bgunebakan/Robotic-arm/zortrax robot arm/manual Robotic Arm/Ver 2015/SolidWorks files/Grasper Assembly.SLDASM

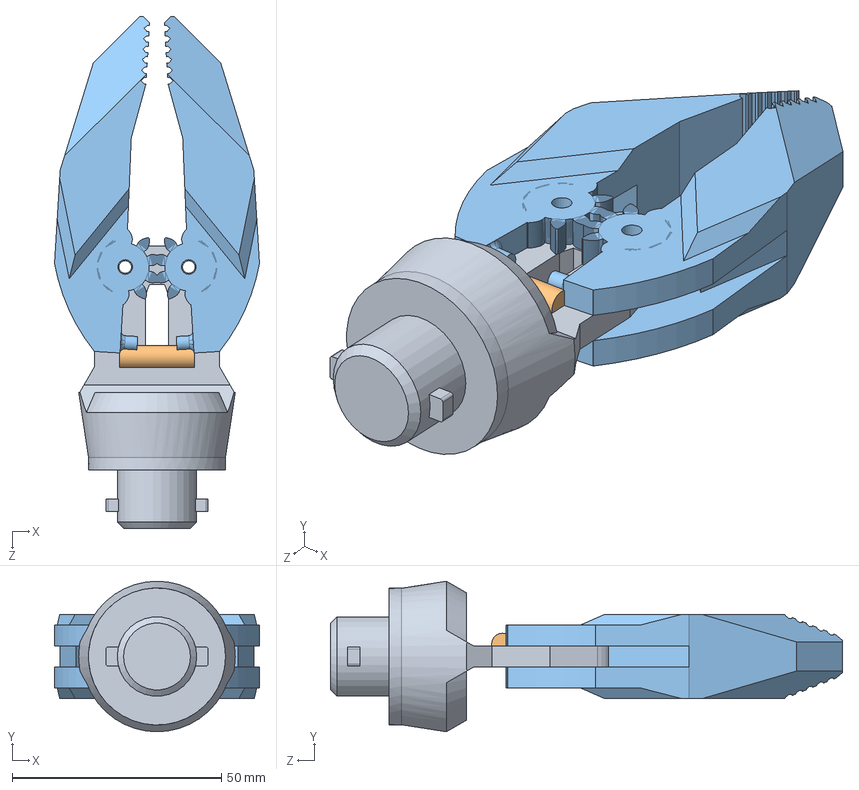
[picture p1: CAD file, 2015-10-21]
zortrax robot arm/manual Robotic Arm/Ver 2015/SolidWorks files/Grasper Assembly.SLDASM
49.0 x 36.0 x 122.4 mm
Grasper Body
Spring
Grasper x 2
