bgunebakan/Robotic-arm/bilalin yolu/Robot Arm New.SLDASM

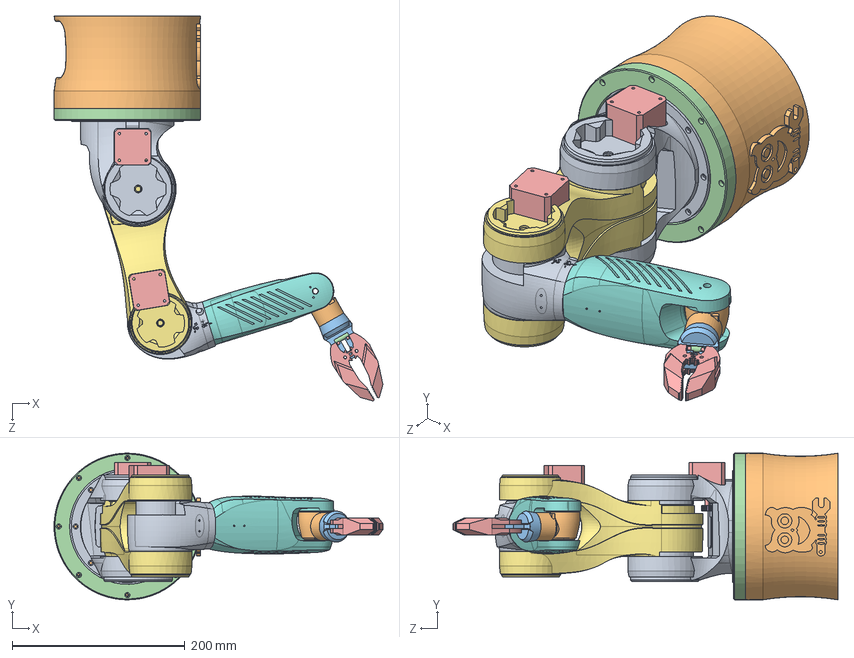
[picture p2: CAD file, 2015-11-02]
bilalin yolu/Robot Arm New.SLDASM
381.2 x 170.0 x 446.2 mm
Base
Support
Ball x 32
Ring
Small Gear x 3
arm
Nema 17 x 33 x 3
arm3
arm2
arm5
Grasper Body
Spring
Grasper x 2
Bearing 608 x 4
Shaft 8x80 x 2
