bgunebakan/Robotic-arm/zortrax robot arm/manual Robotic Arm/Ver 2015/SolidWorks files/Robot Arm New.SLDASM

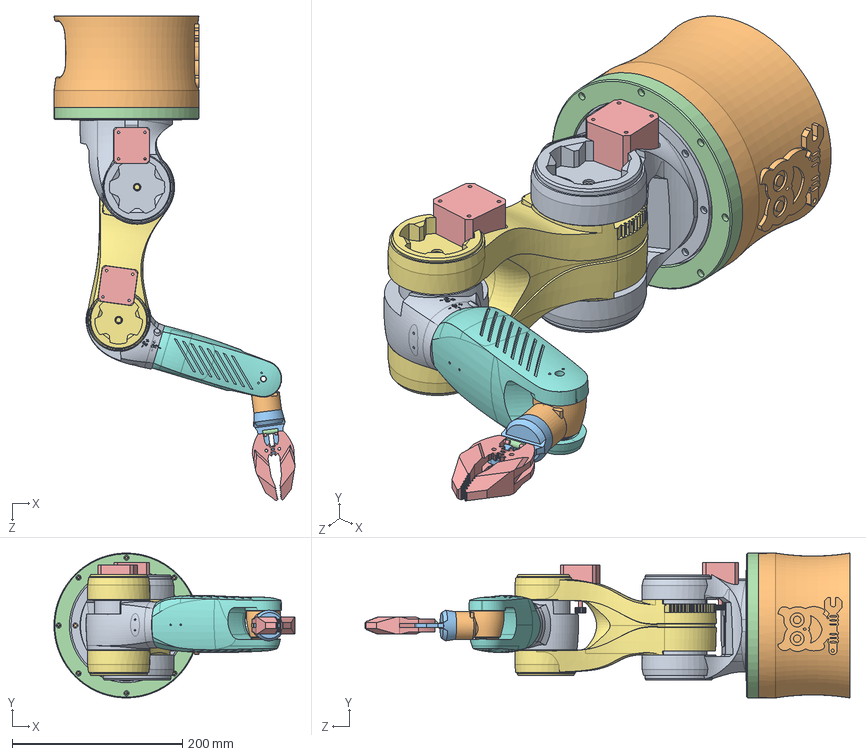
[picture p3: CAD file, 2015-10-21]
zortrax robot arm/manual Robotic Arm/Ver 2015/SolidWorks files/Robot Arm New.SLDASM
282.8 x 170.0 x 568.5 mm
Base
Support
Ball x 32
Ring
Small Gear x 3
arm
Nema 17 x 33 x 3
arm3
arm2
arm5
Grasper Body
Spring
Grasper x 2
Bearing 608 x 4
Shaft 8x80 x 2
