bgunebakan/Robotic-arm/bilalin yolu/Ring.sldprt

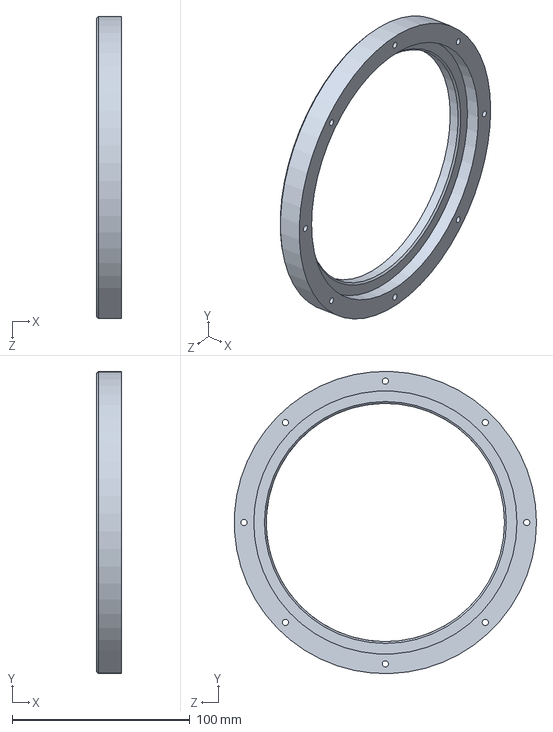
[picture p4: CAD file, 2015-11-02]
bilalin yolu/Ring.sldprt
14.0 x 169.9 x 169.9 mm
