bgunebakan/Robotic-arm/bilalin yolu/STL/Base.STL

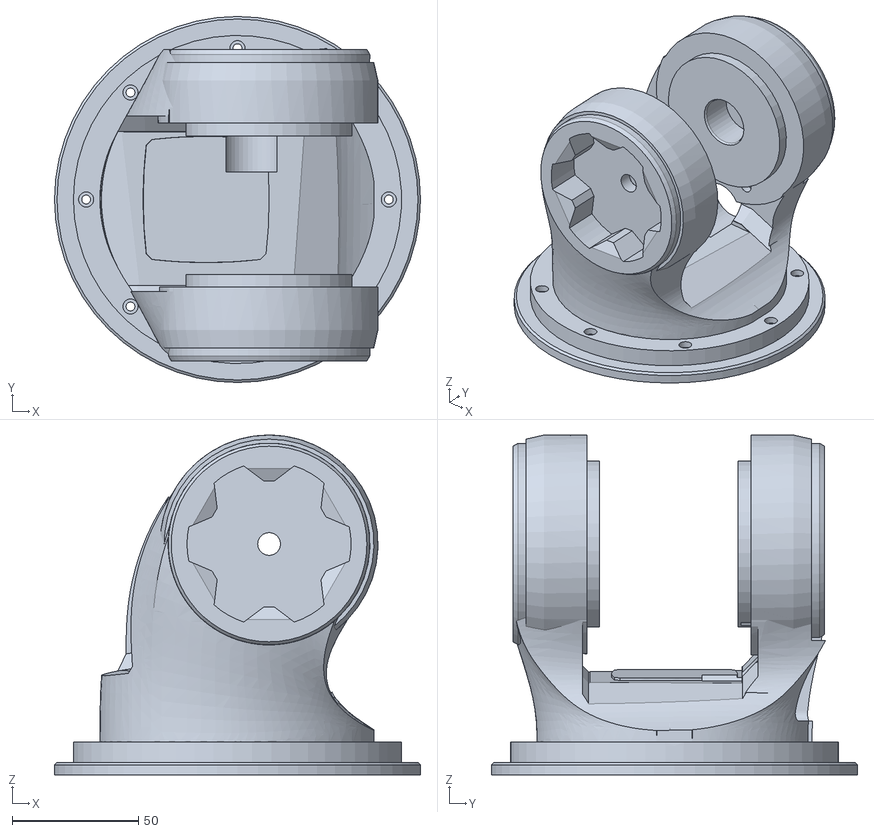
[picture p5: CAD file, 2015-11-02]
bilalin yolu/STL/Base.STL
145.0 x 145.0 x 134.7
