bgunebakan/Robotic-arm/zortrax robot arm/manual Robotic Arm/Ver 2015/Small gear.stl

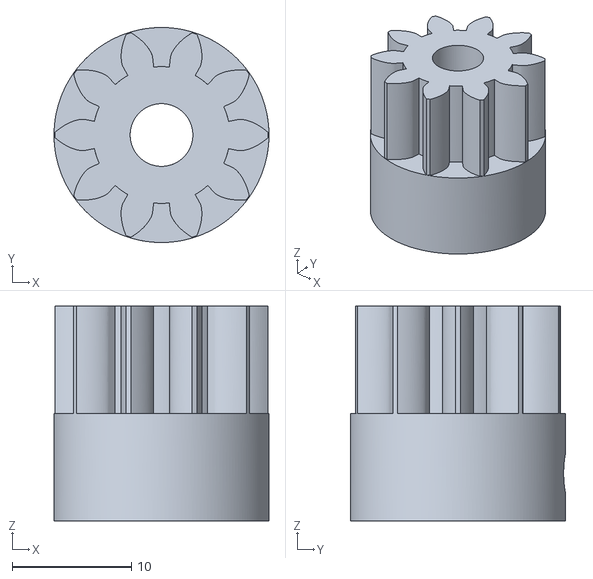
[picture p6: CAD file, 2015-10-19]
zortrax robot arm/manual Robotic Arm/Ver 2015/Small gear.stl
18.0 x 18.0 x 18.0
