bgunebakan/Robotic-arm/bilalin yolu/STL/arm.STL

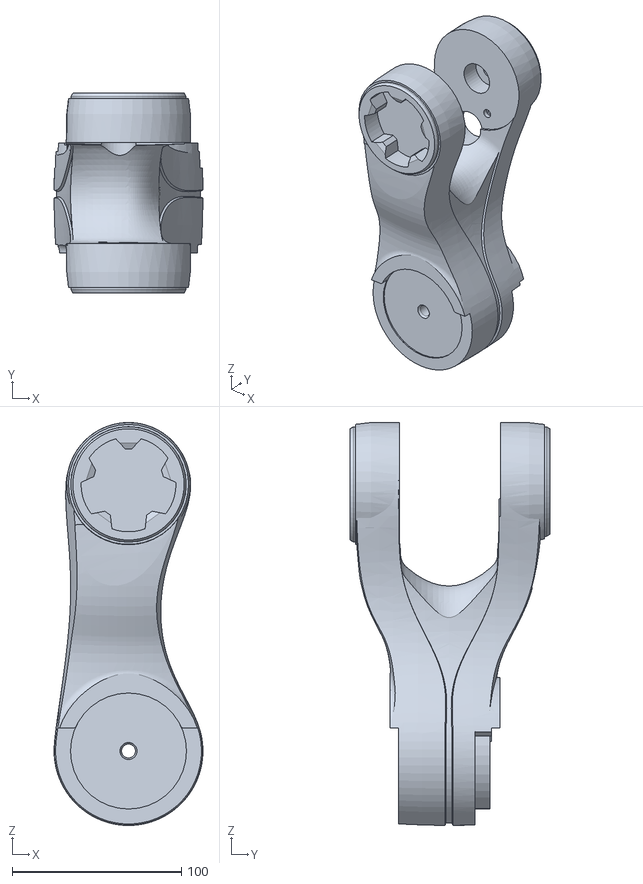
[picture p7: CAD file, 2015-11-02]
bilalin yolu/STL/arm.STL
88.0 x 118.3 x 238.1
