bgunebakan/Robotic-arm/zortrax robot arm/manual Robotic Arm/Ver 2015/Side lid arm R.STL

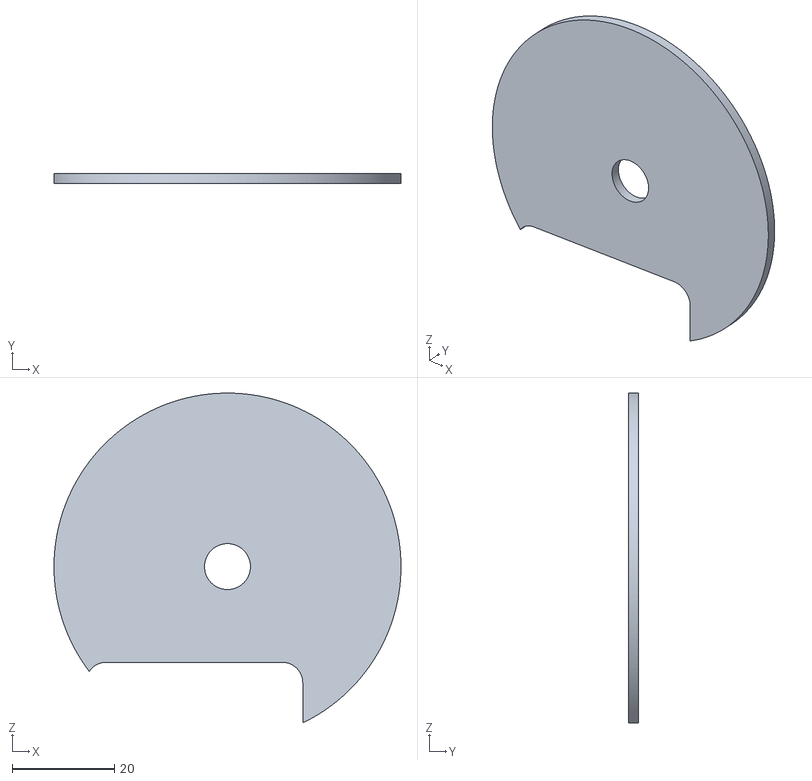
[picture p8: CAD file, 2015-10-19]
zortrax robot arm/manual Robotic Arm/Ver 2015/Side lid arm R.STL
68.0 x 2.00 x 64.6
