bgunebakan/Robotic-arm/zortrax robot arm/manual Robotic Arm/Ver 2015/SolidWorks files/arm2.sldprt

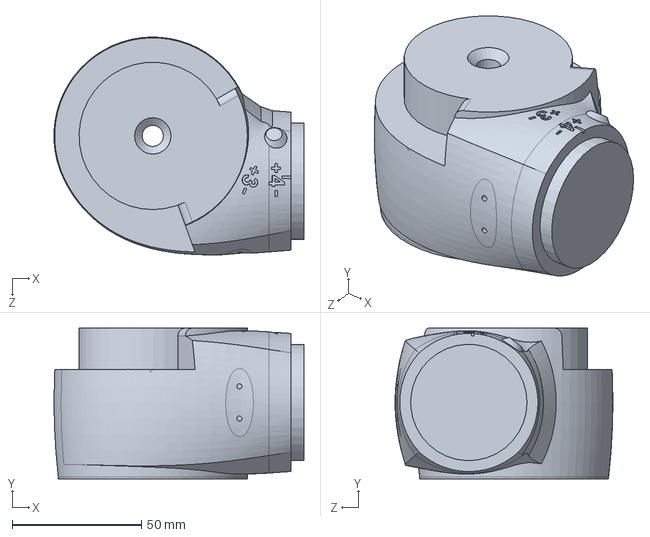
[picture p9: CAD file, 2015-10-21]
zortrax robot arm/manual Robotic Arm/Ver 2015/SolidWorks files/arm2.sldprt
96.7 x 58.3 x 84.3 mm
