bgunebakan/Robotic-arm/bilalin yolu/Small Gear.SLDPRT

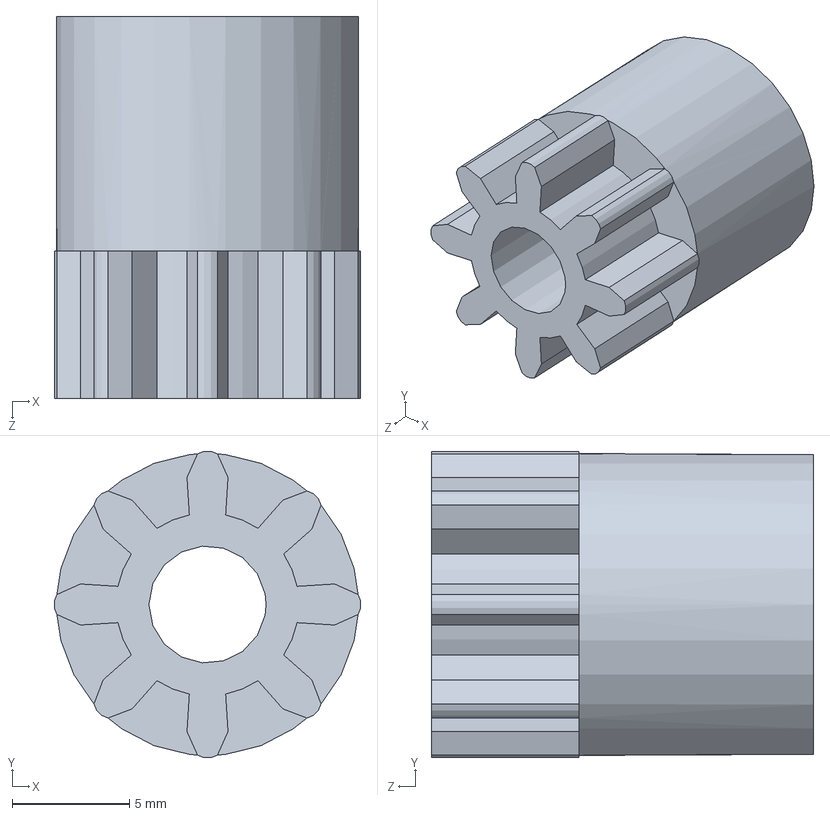
[picture p10: CAD file, 2015-11-02]
bilalin yolu/Small Gear.SLDPRT
13.1 x 13.1 x 16.3 mm
