bgunebakan/Robotic-arm/zortrax robot arm/manual Robotic Arm/Ver 2015/Grasper 2.STL

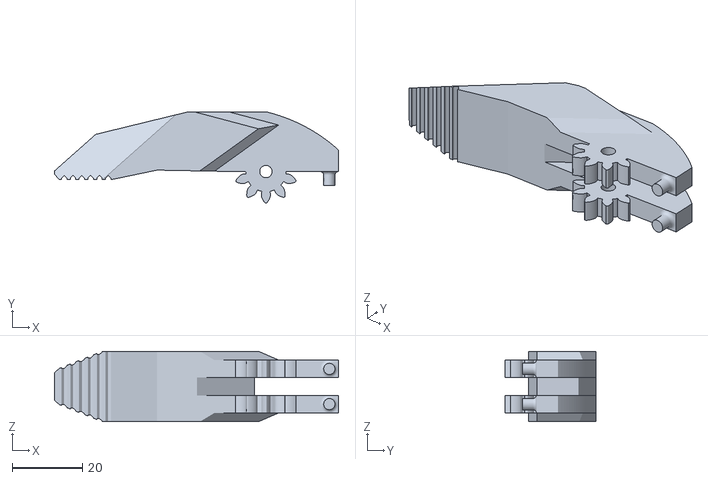
[picture p11: CAD file, 2015-10-19]
zortrax robot arm/manual Robotic Arm/Ver 2015/Grasper 2.STL
80.6 x 25.9 x 20.0
