bgunebakan/Robotic-arm/zortrax robot arm/manual Robotic Arm/Ver 2015/SolidWorks files/Support.sldprt

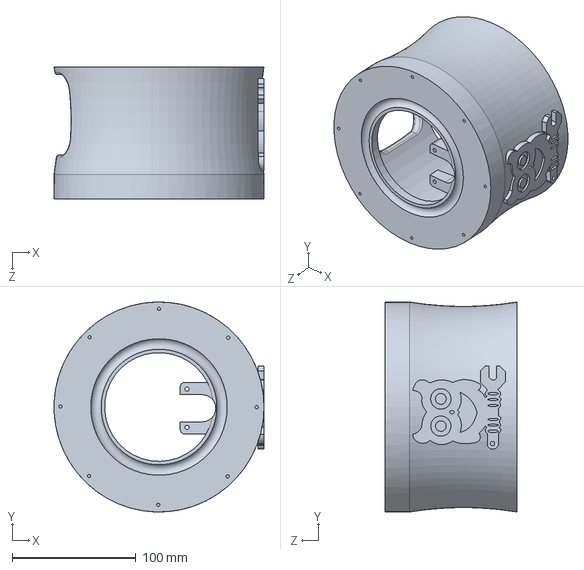
[picture p12: CAD file, 2015-10-21]
zortrax robot arm/manual Robotic Arm/Ver 2015/SolidWorks files/Support.sldprt
170.0 x 170.0 x 107.0 mm
