bgunebakan/Robotic-arm/zortrax robot arm/manual Robotic Arm/Ver 2015/Side cover arm L.STL

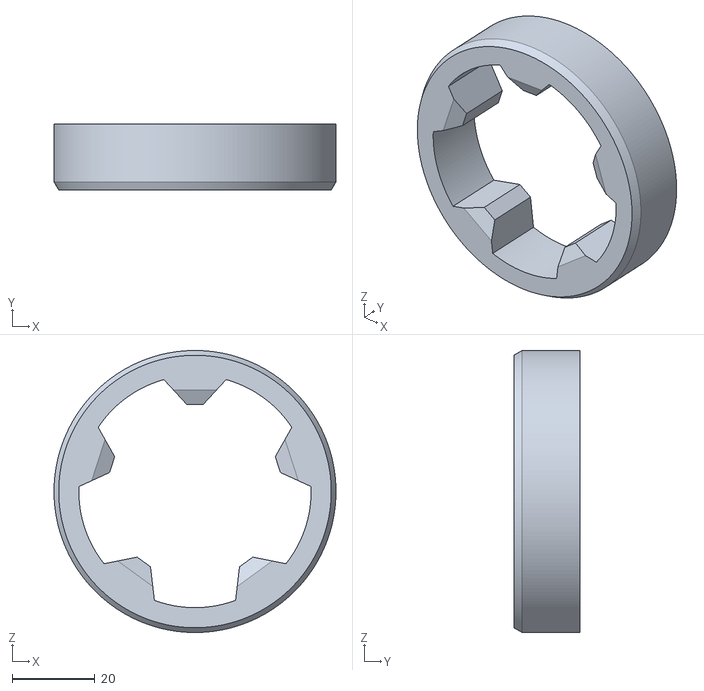
[picture p13: CAD file, 2015-10-19]
zortrax robot arm/manual Robotic Arm/Ver 2015/Side cover arm L.STL
68.0 x 16.0 x 68.0
