bgunebakan/Robotic-arm/zortrax robot arm/manual Robotic Arm/Ver 2015/Toothed ring.STL

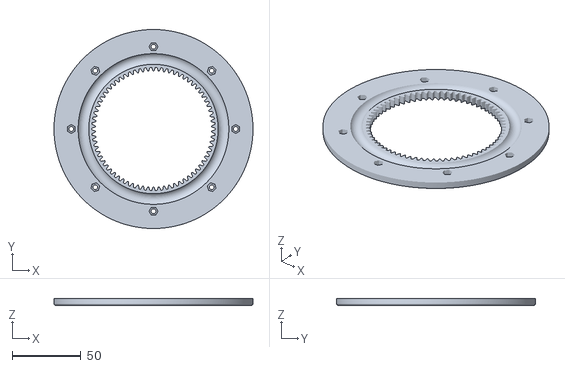
[picture p14: CAD file, 2015-10-19]
zortrax robot arm/manual Robotic Arm/Ver 2015/Toothed ring.STL
145.0 x 145.0 x 5.00
