bgunebakan/Robotic-arm/zortrax robot arm/manual Robotic Arm/Ver 2015/Vertical axis gear.STL

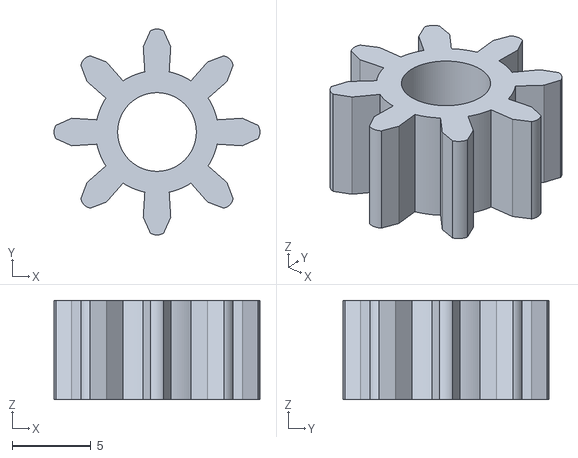
[picture p15: CAD file, 2015-10-19]
zortrax robot arm/manual Robotic Arm/Ver 2015/Vertical axis gear.STL
13.1 x 13.1 x 6.30
