bgunebakan/Robotic-arm/bilalin yolu/Arm 1 gear.SLDPRT

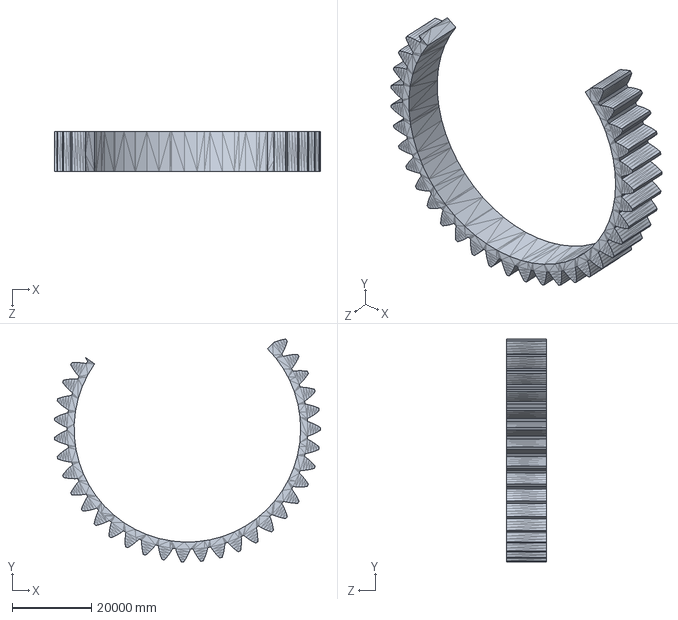
[picture p16: CAD file, 2015-10-19]
bilalin yolu/Arm 1 gear.SLDPRT
66932.2 x 56078.7 x 10000.0 mm
