bgunebakan/Robotic-arm/zortrax robot arm/manual Robotic Arm/Ver 2015/Side lid arm L.STL

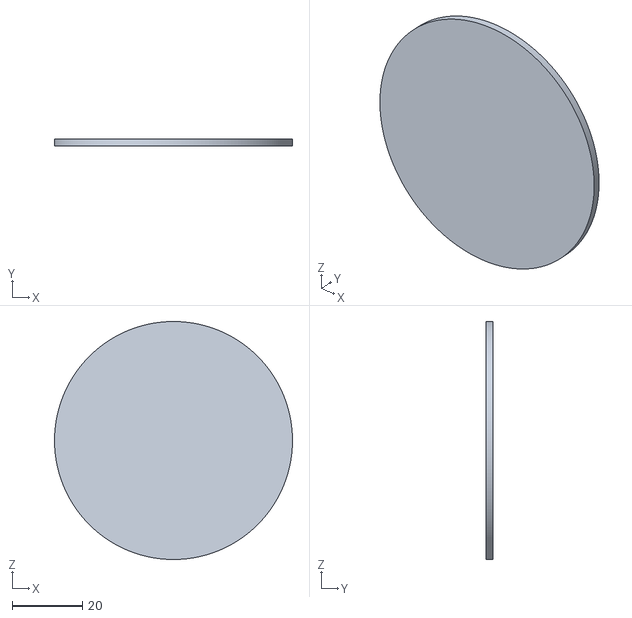
[picture p17: CAD file, 2015-10-19]
zortrax robot arm/manual Robotic Arm/Ver 2015/Side lid arm L.STL
68.0 x 2.00 x 68.0
