bgunebakan/Robotic-arm/bilalin yolu/Grasper Mirror.SLDPRT

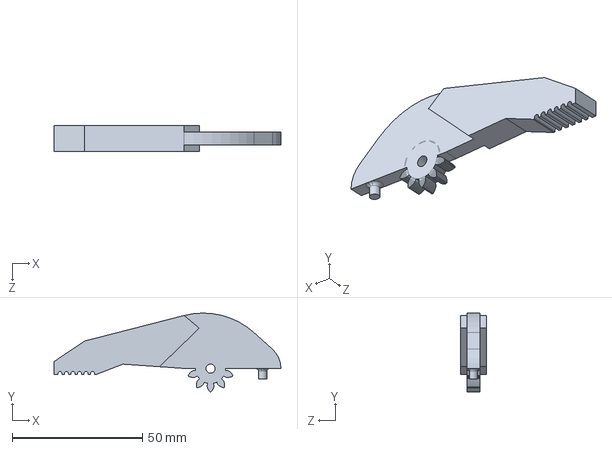
[picture p18: CAD file, 2015-10-19]
bilalin yolu/Grasper Mirror.SLDPRT
87.0 x 30.2 x 10.0 mm
