bgunebakan/Robotic-arm/zortrax robot arm/manual Robotic Arm/Ver 2015/Side cover arm R.STL

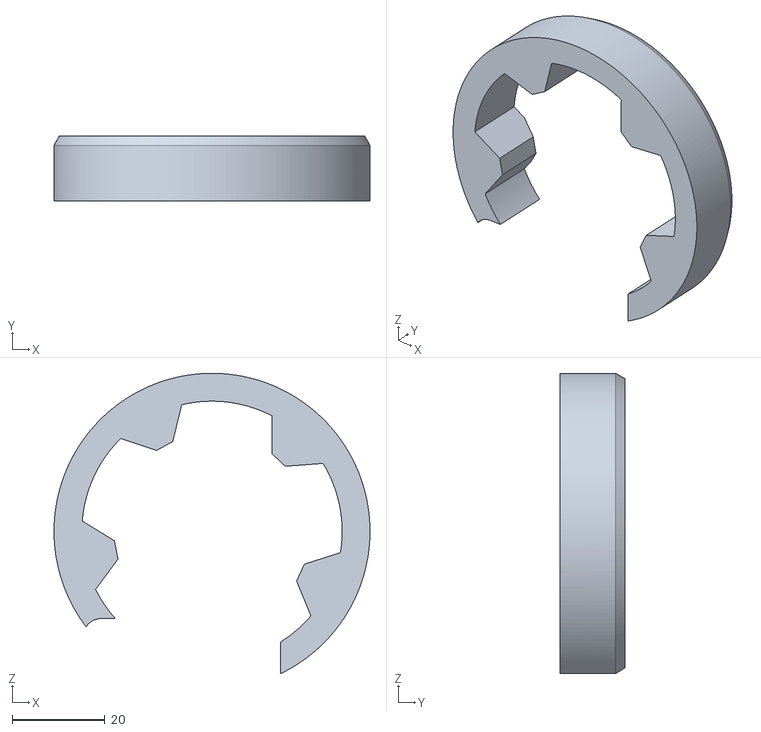
[picture p19: CAD file, 2015-10-19]
zortrax robot arm/manual Robotic Arm/Ver 2015/Side cover arm R.STL
68.0 x 14.0 x 64.6
