bgunebakan/Robotic-arm/bilalin yolu/Nema 17 x 33.SLDPRT

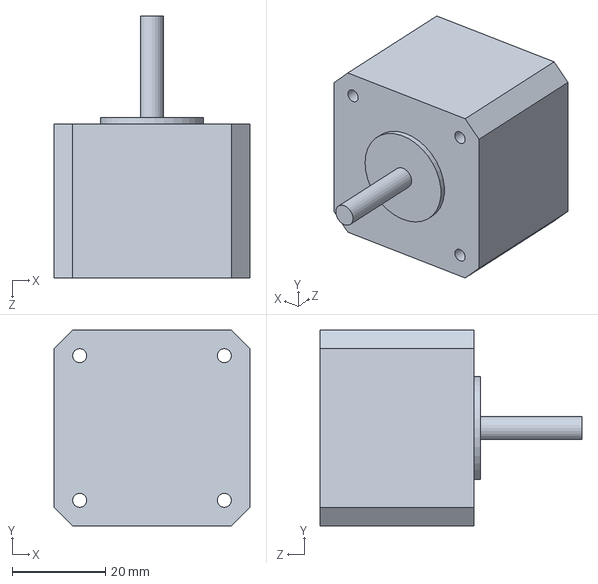
[picture p20: CAD file, 2015-10-19]
bilalin yolu/Nema 17 x 33.SLDPRT
42.0 x 42.0 x 56.0 mm
