bgunebakan/Robotic-arm/zortrax robot arm/manual Robotic Arm/Ver 2015/Arm 1 upper.STL

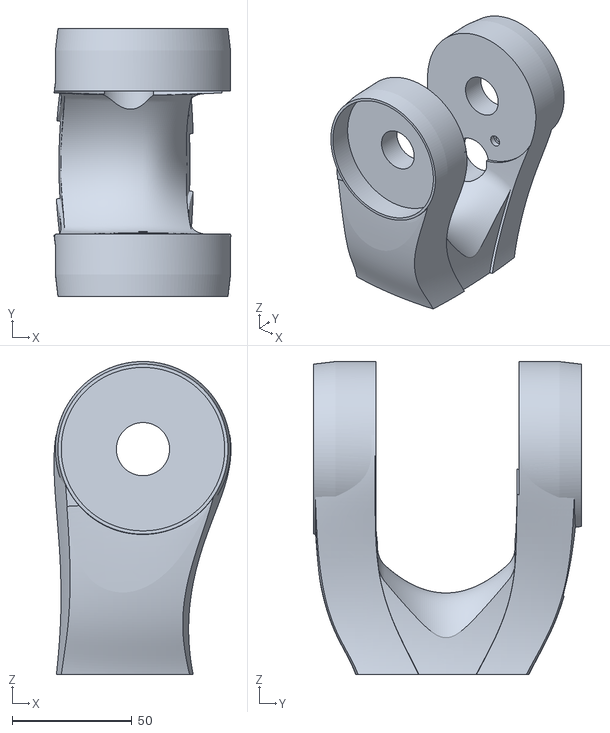
[picture p21: CAD file, 2015-10-19]
zortrax robot arm/manual Robotic Arm/Ver 2015/Arm 1 upper.STL
73.9 x 111.9 x 130.6
