bgunebakan/Robotic-arm/bilalin yolu/Bearing 608.SLDPRT

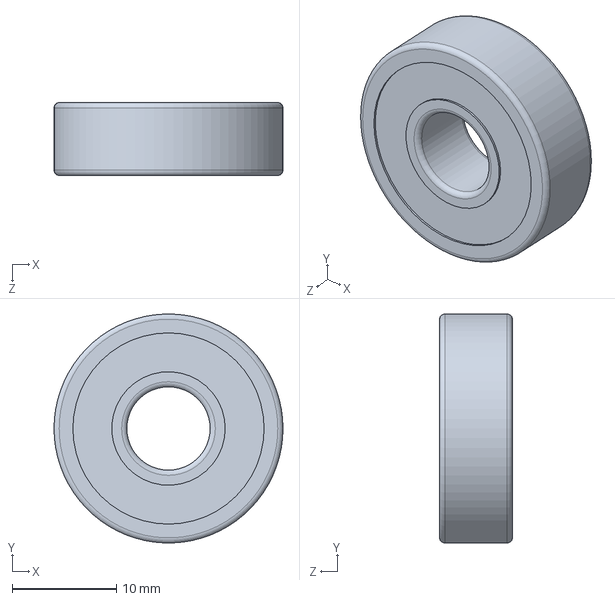
[picture p22: CAD file, 2015-10-19]
bilalin yolu/Bearing 608.SLDPRT
22.0 x 22.0 x 7.00 mm
