bgunebakan/Robotic-arm/zortrax robot arm/manual Robotic Arm/Ver 2015/Side cover base L.STL

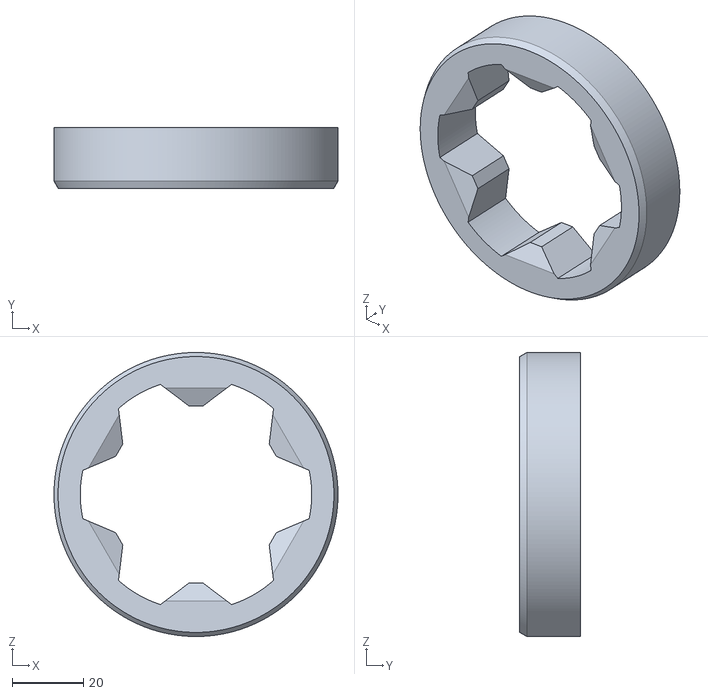
[picture p23: CAD file, 2015-10-19]
zortrax robot arm/manual Robotic Arm/Ver 2015/Side cover base L.STL
79.8 x 17.0 x 79.8
