bgunebakan/Robotic-arm/bilalin yolu/Ball.SLDPRT

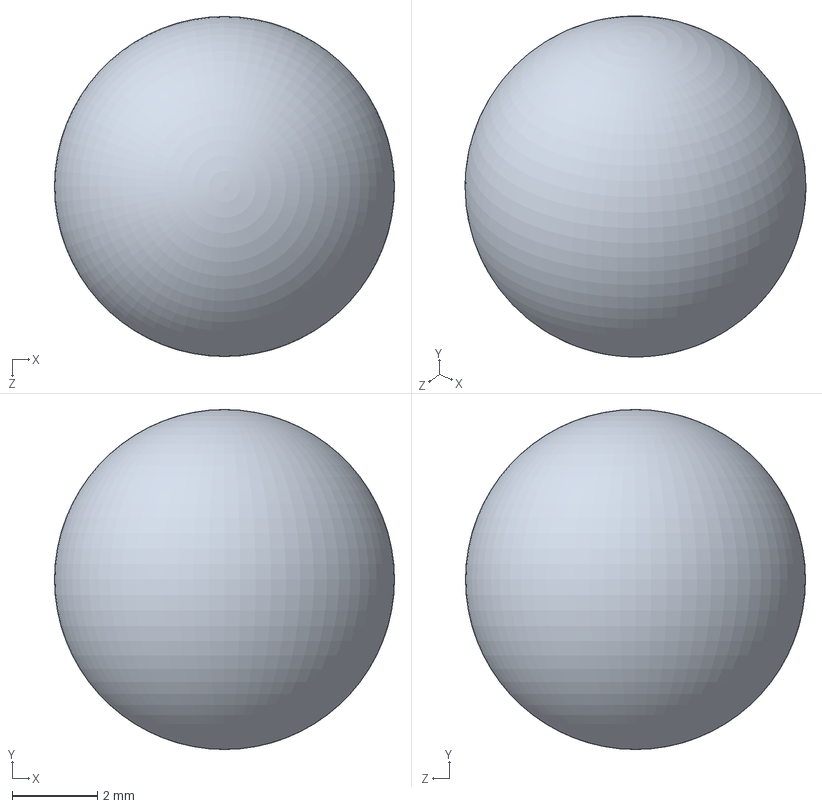
[picture p24: CAD file, 2015-10-19]
bilalin yolu/Ball.SLDPRT
8.00 x 8.00 x 8.00 mm
