bgunebakan/Robotic-arm/zortrax robot arm/manual Robotic Arm/Ver 2015/Arm 1 lower.STL

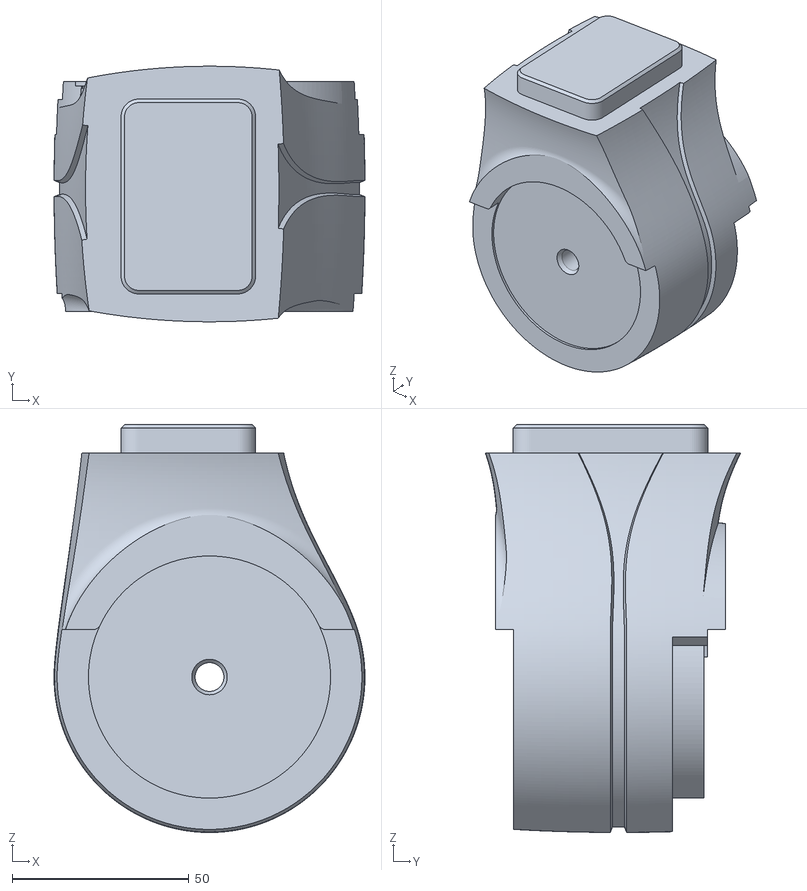
[picture p25: CAD file, 2015-10-19]
zortrax robot arm/manual Robotic Arm/Ver 2015/Arm 1 lower.STL
88.0 x 72.3 x 115.5
