bgunebakan/Robotic-arm/bilalin yolu/Spring.SLDPRT

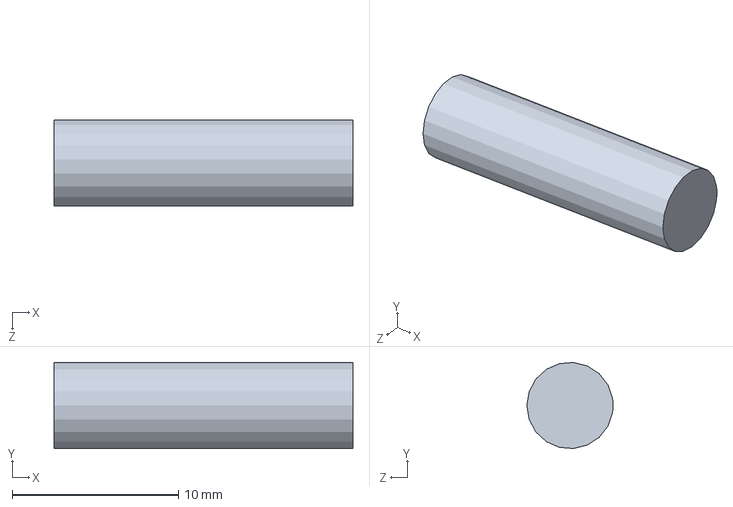
[picture p26: CAD file, 2015-10-19]
bilalin yolu/Spring.SLDPRT
18.0 x 5.18 x 5.20 mm
