bgunebakan/Robotic-arm/zortrax robot arm/manual Robotic Arm/Ver 2015/Grasper holder.STL

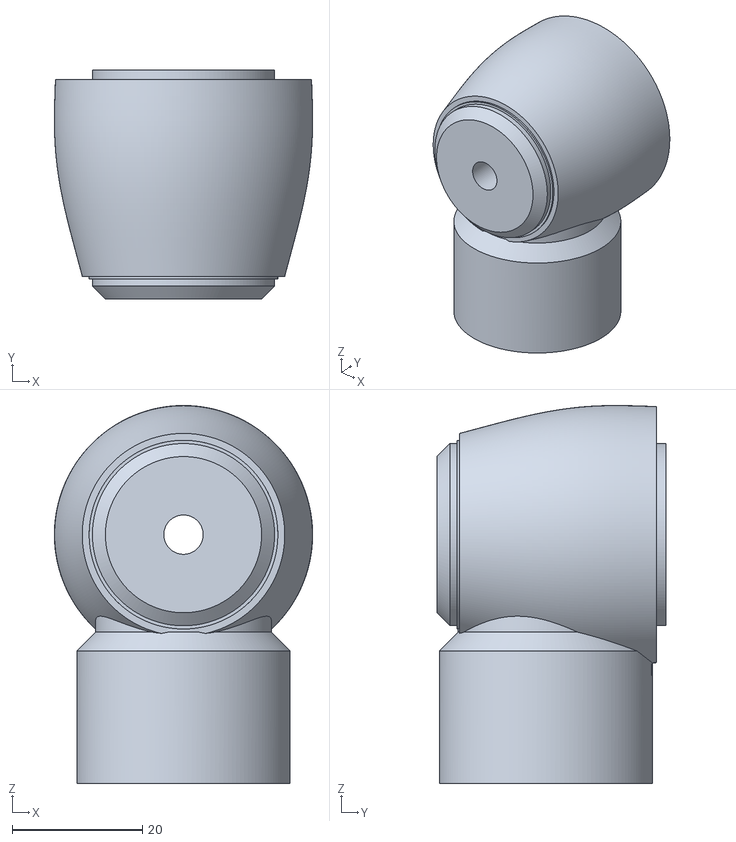
[picture p27: CAD file, 2015-10-19]
zortrax robot arm/manual Robotic Arm/Ver 2015/Grasper holder.STL
39.7 x 35.2 x 58.1
