bgunebakan/Robotic-arm/bilalin yolu/Shaft 8x80.SLDPRT

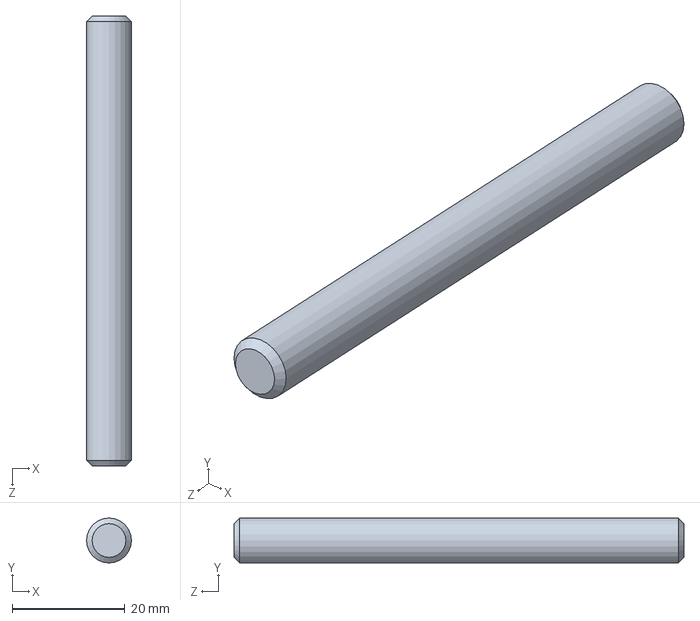
[picture p28: CAD file, 2015-10-19]
bilalin yolu/Shaft 8x80.SLDPRT
8.00 x 8.00 x 80.0 mm
