bgunebakan/Robotic-arm/zortrax robot arm/manual Robotic Arm/Ver 2015/Base gear.STL

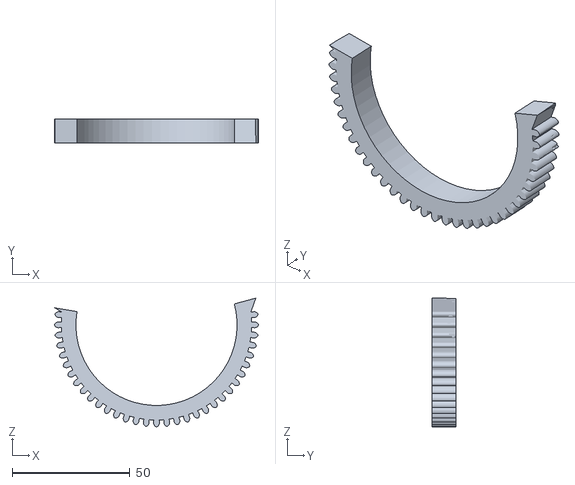
[picture p29: CAD file, 2015-10-19]
zortrax robot arm/manual Robotic Arm/Ver 2015/Base gear.STL
86.7 x 10.0 x 54.7
