bgunebakan/Robotic-arm/zortrax robot arm/manual Robotic Arm/Ver 2015/Grasper Body.STL

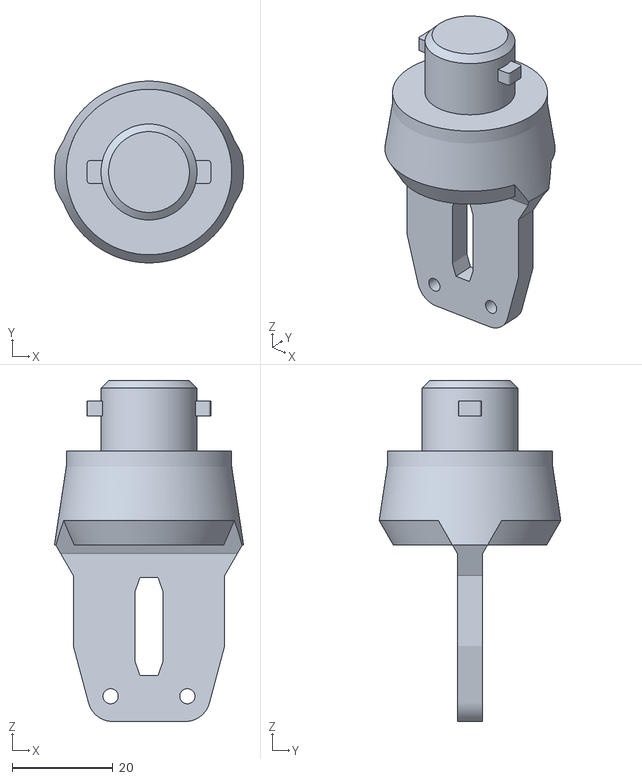
[picture p30: CAD file, 2015-10-19]
zortrax robot arm/manual Robotic Arm/Ver 2015/Grasper Body.STL
37.4 x 36.0 x 67.5
