bgunebakan/Robotic-arm/zortrax robot arm/manual Robotic Arm/Ver 2015/Arm 3.STL

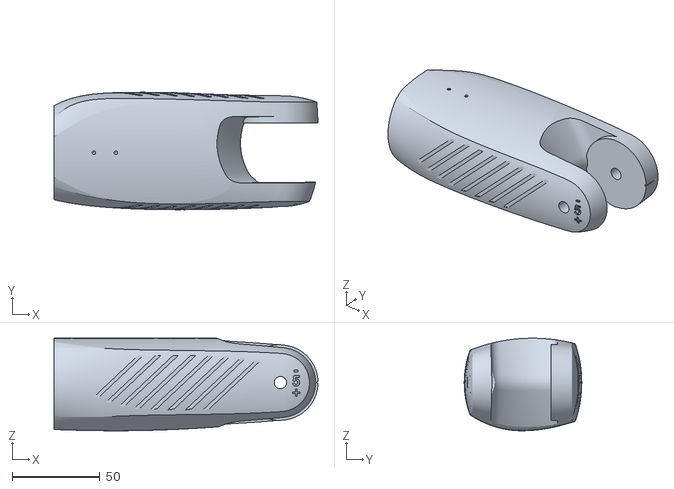
[picture p31: CAD file, 2015-10-19]
zortrax robot arm/manual Robotic Arm/Ver 2015/Arm 3.STL
150.4 x 67.0 x 52.8
