bgunebakan/Robotic-arm/bilalin yolu/arm3.sldprt

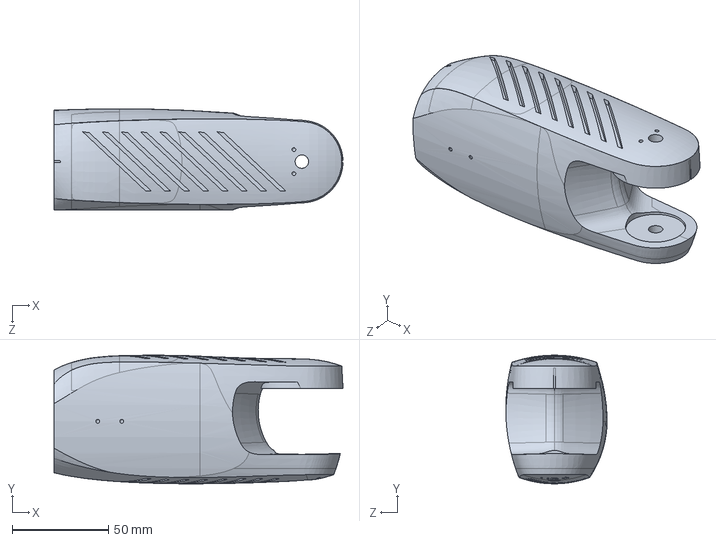
[picture p32: CAD file, 2015-10-19]
bilalin yolu/arm3.sldprt
150.4 x 67.0 x 52.8 mm
