bgunebakan/Robotic-arm/zortrax robot arm/manual Robotic Arm/Ver 2015/Base.STL

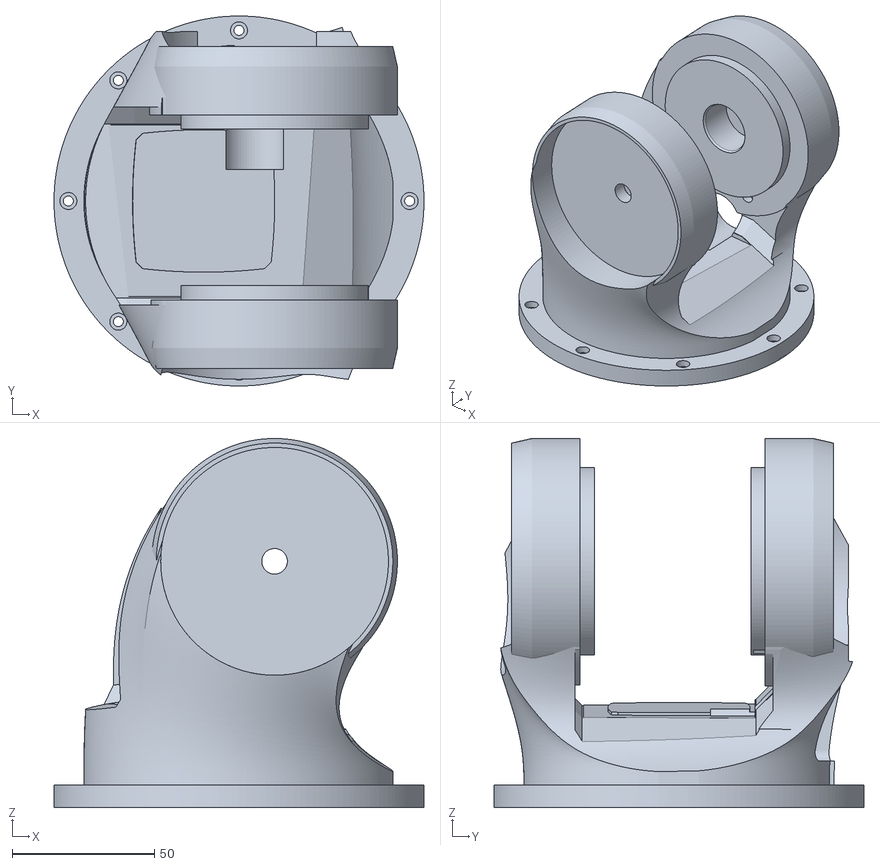
[picture p33: CAD file, 2015-10-19]
zortrax robot arm/manual Robotic Arm/Ver 2015/Base.STL
130.0 x 130.0 x 129.7
