bgunebakan/Robotic-arm/zortrax robot arm/manual Robotic Arm/Ver 2015/Side cover base R.STL

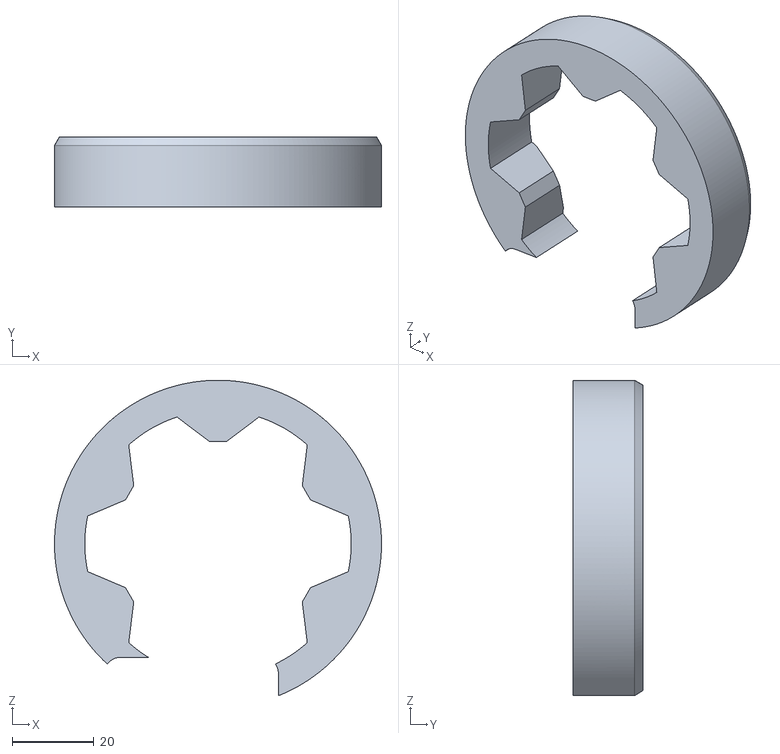
[picture p34: CAD file, 2015-10-19]
zortrax robot arm/manual Robotic Arm/Ver 2015/Side cover base R.STL
79.8 x 17.0 x 77.0
