bgunebakan/Robotic-arm/zortrax robot arm/manual Robotic Arm/Ver 2015/Grasper 1.STL

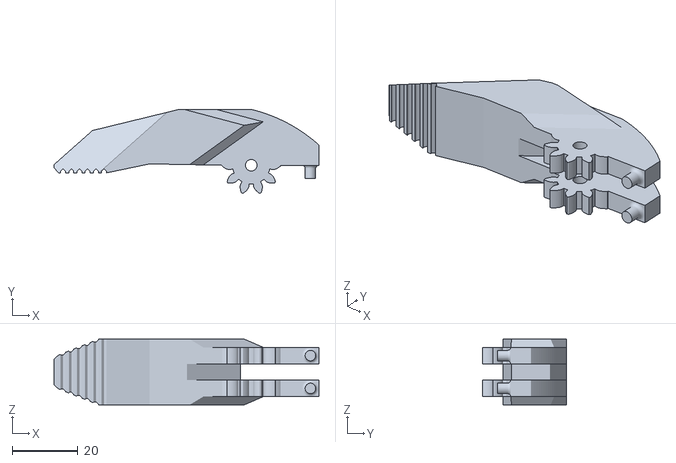
[picture p35: CAD file, 2015-10-19]
zortrax robot arm/manual Robotic Arm/Ver 2015/Grasper 1.STL
80.6 x 25.5 x 20.0
