bgunebakan/Robotic-arm/zortrax robot arm/manual Robotic Arm/Ver 2015/Arm 1 gear.STL

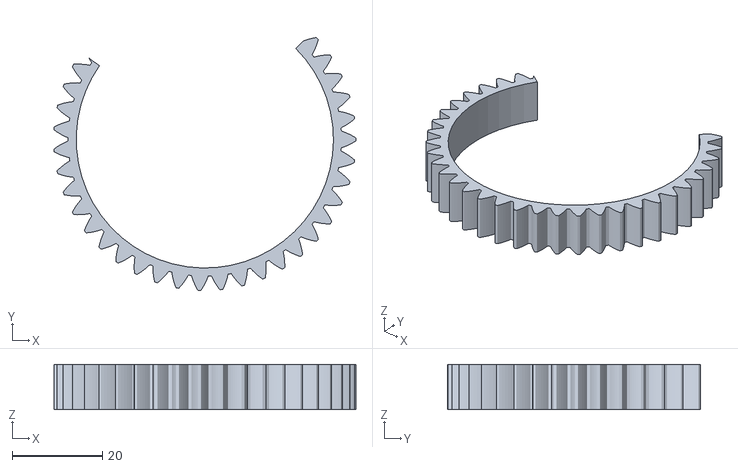
[picture p36: CAD file, 2015-10-19]
zortrax robot arm/manual Robotic Arm/Ver 2015/Arm 1 gear.STL
66.9 x 56.1 x 10.0
