bgunebakan/Robotic-arm/(list of files, cad)

Other CAD files:
bilalin yolu/Support.sldprt
zortrax robot arm/manual Robotic Arm/Ver 2015/SolidWorks files/Ring.sldprt
bilalin yolu/arm5.sldprt
bilalin yolu/Grasper Body.SLDPRT
bilalin yolu/Arm1 gear.SLDPRT
bilalin yolu/STL/Ring.STL
bilalin yolu/STL/Support.STL
bilalin yolu/STL/arm3.STL
zortrax robot arm/manual Robotic Arm/Ver 2015/Arm 2.STL
zortrax robot arm/manual Robotic Arm/Ver 2015/Ring.STL
zortrax robot arm/manual Robotic Arm/Ver 2015/Support.STL
