bgunebakan/Robotic-arm/(commit log)

2015-10-19 örnek robot kol eklendi Signed-off-by: Bilal Tonga <bilaltonga@gmail.com>
    [Arm 1 gear.SLDPRT, Arm 1 gear.STL, Arm 1 lower.STL, Arm 1 upper.STL, Arm 2.STL, Arm 3.STL, Arm1 gear.SLDPRT, Ball.SLDPRT]
2015-10-21 kendbilalin remixi olacak
    [Arm 1 gear.SLDPRT, Arm1 gear.SLDPRT, Ball.SLDPRT, Bearing 608.SLDPRT, Grasper Assembly.SLDASM, Grasper Body.SLDPRT, Grasper Mirror.SLDPRT, Nema 17 x 33.SLDPRT]
2015-11-02 work on base and gears
    [Base.STL, Ring.STL, Ring.sldprt, Robot Arm New.SLDASM, Small Gear.SLDPRT, Support.STL, Support.sldprt, arm.STL]
